ekundo/combolite/software/README.md

# Программы для «Вектора»

Программы под МикроДОС для платы ComboLite: терминал, IRC и Gopher через
Wi-Fi модем платы и настройки платы с самого «Вектора». Здесь только
исполняемые файлы, без исходников; свободно для некоммерческого
использования.

| файл | что |
|---|---|
| `TERM.COM` | терминал для BBS по telnet: ANSI, кодировки, прием файлов по XMODEM и Kermit |
| `IRC.COM` | клиент IRC |
| `GOPHER.COM` | клиент Gopher, в том числе для сайтов на GitHub Pages |
| `CL.COM` | настройки платы |
| `IRC.INI`, `GOPHER.INI` | примеры настроек: сервер и ник IRC, закладки Gopher |

Файлы нужно записать на дискету винчестера, на квазидиск или на дискету, как
любые другие программы. Модем — порты `28h`-`2Dh` (UART 16550), его устройство
описано в [MODEM.md](../doc/MODEM.md). TERM, IRC и GOPHER работают и в
эмуляторах, которые изображают этот модем.

## Настройки платы: CL.COM

Настройки платы, те же, что в веб-интерфейсе, меняет программа `CL.COM` под
МикроДОС, без компьютера и телефона. Ее нужно записать на дискету винчестера или на квазидиск, как любую
другую программу.

```
CL                       показать настройки и ждать команд
CL VGA=50 AUTO=OFF       поменять одну или несколько и показать итог
CL ?                     подсказка
```

Без параметров программа показывает настройки и ждет строк вида
`ИМЯ=ЗНАЧЕНИЕ`, несколько через пробел. Пустая строка — выход. Возможные
значения выписаны в скобках рядом с каждой настройкой:

| имя | что | значения |
|---|---|---|
| `BOOT` | загрузчик | `ROM`, `BOOT26` (`POWER` — старая настройка «только при включении») |
| `AUTO` | автозапуск загруженного | `ON`, `OFF` |
| `VGA` | выход VGA | `60`, `50` |
| `VI53` | звук таймера платы | `ON` — наш, `OFF` — «Вектора» |
| `FDC`, `KVAZ1`, `KVAZ2`, `IDE`, `AY`, `MIRROR` | устройства: дисковод, квазидиски 10h и 11h, винт, AY, зеркало экрана | `ON`, `OFF` |
| `READY` | готовность дисковода | `INDEX`, `34`, `ALWAYS` |
| `CABLE` | шлейф дисковода | `SHUGART`, `PC` |
| `PRECOMP`, `TG43` | предкомпенсация записи: шагов по 62,5 нс и «только с 44-й дорожки» | `0`-`8`; `ON`, `OFF` |

Изменение действует сразу и запоминается, как из веб-интерфейса. Все поля
уходят на плату вместе: если одно значение не подходит, не меняется ничего.
`IDE=OFF` прячет от «Вектора» винчестер, с которого программа, скорее всего,
и загружена: вернуть его можно из веб-интерфейса или той же программой с
дискеты или квазидиска.

`CL.COM` говорит с платой через порты `28h`-`2Dh` (UART 16550, за ним
модем; программа переводит канал в кадры настроек строкой `AT*CL`, а на
выходе возвращает модем), настройки хранит ESP.
Если программа пишет `No ComboLite`, плата не отвечает на порт `2Dh`. Если
пишет, что ESP не отвечает, в плате прошивка ПЛИС или ESP без этого канала:
обновите обе.

## Терминал: TERM.COM и Wi-Fi модем

Плата работает как Wi-Fi модем Hayes: ESP держит соединение и понимает
AT-команды, а «Вектор» видит модем как COM-порт с UART 16550 на портах
`28h`-`2Dh` (`28h` — данные, `2Dh` — состояние). Подойдут и старые программы
под такой порт, если принимают опросом, а не по прерыванию. Устройство
портов и команды модема описаны в
[MODEM.md](../doc/MODEM.md): тот же модем может изобразить и эмулятор. Терминал,
разбор ANSI, кодировки и прием файлов — программа `TERM.COM` на самом
«Векторе». Так доступны BBS, чаты и сетевые игры по telnet.

```
TERM          кодировку BBS терминал определяет сам
TERM /437     CP437 (англоязычные BBS, ANSI-арт)
TERM /866     CP866 (русские BBS)
TERM /1251    CP1251
TERM /KOI8    KOI8-R
TERM /UTF     UTF-8
TERM ?        справка
```

Кодировку TERM узнает по тому, что шлет BBS: правильные последовательности
UTF-8 — это UTF-8. Иначе байты 8-битные, и кодировку решают частые русские
буквы (о, е, а, и, н, т, с, р, в, л): в CP866, CP1251 и KOI8-R они стоят на
разных местах. Шесть таких букв — и кодировка выбрана. Уже нарисованное до
этого не перерисовывается. Пока русских букв нет, рисуется CP437. С каждым
новым соединением кодировка определяется заново. Если TERM ошибается,
запустите его с ключом. Знаков, которых нет в шрифте «Вектора» (CP866),
терминал заменяет похожими: буквы с надстрочными знаками — на латиницу без
них, кавычки, тире и стрелки — на `"`, `-`, `<` `>`, многоточие — на три
точки; совсем незнакомое — `?`.

Без соединения клавиши идут модему, и он понимает AT-команды:

| команда | что |
|---|---|
| `ATDT хост:порт` | соединиться (порт по умолчанию 23) |
| `+++` с паузой в секунду до и после | вернуться к командам, соединение остается |
| `ATO` | снова в соединение |
| `ATH` | разъединиться |
| `ATE0`, `ATE1` | эхо команд выключить, включить |
| `ATI` | имя модема |
| `ATBBS` | сколько BBS в списке |
| `ATBBS слово` | найти BBS по имени, адресу, программе или месту: до 15 строк с номерами |
| `ATDS n` | соединиться с BBS номер n из списка |
| `ATDL` | набрать прошлый адрес еще раз |
| `A/` | повторить прошлую команду |
| `AT?` | справка по командам |

Список BBS — месячный выпуск [Telnet BBS Guide](https://www.telnetbbsguide.com).
ESP скачивает его сама при первой команде `ATBBS` или `ATDS` (нужен интернет,
это занимает несколько секунд) и держит в памяти сутки, потом берет свежий.
В прошивку список не вшит: он меняется каждый месяц, а условия Telnet BBS Guide
не разрешают включать его в программы без спроса. Номера BBS действуют внутри
одного выпуска.

Стрелки вверх и вниз в командах модема вспоминают прежние строки. Историю,
20 строк, TERM хранит в файле `TERM.HIS` на текущем диске: читает при входе,
пишет при выходе. Пока модем в соединении, стрелки уходят на BBS. Что модем в
командах, TERM понимает по его ответам: `CONNECT` — соединение; `OK`, `ERROR`,
`NO CARRIER`, `NO ANSWER` — команды.

| клавиши | что |
|---|---|
| `УС`+`1` | справка по клавишам |
| `УС`+`2` | набрать: прежние адреса из истории или новый |
| `УС`+`3` | файлы: принять по XMODEM, принять или передать по Kermit |
| `УС`+`4` | положить трубку, даже если BBS не отвечает: `+++` и `ATH` с паузами |
| `УС`+`5`, правая кнопка мыши | меню |
| `УС`+`Q` | выход в ОС: сначала TERM кладет трубку (`+++` и `ATH`, около 3 с), чтобы следующая программа не попала в чужое соединение. На РУС это `УС`+`Я` |
| `АР2` | ESC на BBS |
| `РУС/ЛАТ` | русские буквы (в кодировке BBS: CP866, CP1251, KOI8-R или UTF-8) |
| стрелки, `F1`-`F5`, `↖`, `СТР` | в соединении — как на ПК (последовательности ANSI) |

**Меню и окна.** В меню «Связь» — набрать, положить трубку, выход; «Файл» —
прием файла; «Вид» — кодировка и число строк; «Справка». Стрелки выбирают,
`ВК` выполняет, `АР2` закрывает. С мышью (протокол KTSerg) меню и списки
работают щелчками, щелчок мимо окна закрывает его. Окна рисуются поверх
экрана BBS; что под ними, TERM на это время кладет на первый квазидиск и потом
возвращает. Поэтому TERM нужно 43 КБ свободного места на первом квазидиске:
два куска, 32 КБ под экран и 11 КБ под копию ОС, каждый целиком в одном банке
по 64 КБ. Файлы и каталог при этом не трогаются, ОС эти блоки по-прежнему
считает свободными. Если места нет, TERM говорит об этом и выходит.

TERM и IRC.COM проверены под МикроДОС T-72 (из ПЗУ и с дискеты), T-34 и RDS:
эти ОС держат свой код в квазидиске за окном A000h-DFFFh, и экран программы его
не задевает. RDS при запуске заводит скрытые `RDS.SYS` и `COMMAND.SYS`; место
программы берут в обход них. ОС, у которой код лежит прямо в видеопамяти,
программа не тронет: скажет об этом и выйдет.

Если прошлая программа вышла, не положив трубку (например, «Вектор» сбросили),
TERM и IRC.COM при входе узнают это у платы и сами кладут трубку (около
2,5 с).

**Эхо.** Включать и выключать его не нужно: если telnet-сервер не показывает
набранное сам (так делают многие MUD, например `bylins.su:4000`), его
показывает модем. Когда сервер просит пароль и выключает эхо, модем тоже
молчит, и пароль не виден.

**Строка состояния.** Терминал — 80×24, как VT100, и модем сообщает BBS этот
размер. Нижняя строка экрана — строка состояния: на связи или в командах
модема, адрес (если набирали из TERM), время на связи, кодировка, подсказка.
ANSI-арт, нарисованный под 25 строк, смотрите с «Вид» → «25 строк»: строка
состояния уходит, терминал занимает весь экран. Обратно — тем же пунктом.

Если BBS ушла, оставив черный цвет на черном, TERM после `NO CARRIER`
возвращает обычные цвета. Само слово `NO CARRIER` тоже видно.

**IRC и другие серверы без telnet.** Если сервер начинает не с команд
telnet, модем передает байты как есть. Эха нет, на `PING` сервера нужно
отвечать самому. Для IRC есть отдельная программа, `IRC.COM`.

**Прием файла (XMODEM).** Запустите на BBS передачу файла по XMODEM, нажмите
`УС`+`3` и выберите «Принять: XMODEM». TERM спросит имя файла (можно с диском: `B:GAME.ZIP`; пустая строка —
назад в терминал), и дальше файл идет на диск, по килобайту на строке. Любая
клавиша прерывает прием, недокачанный файл удаляется. Блоки по 128 и 1024
байта, CRC-16 или контрольная сумма, повторы при сбоях. На время приема экран —
консоль ОС: TERM возвращает ей память, чтобы писать через нее на диск. Потом
терминал возвращается с пустым экраном. Последний блок XMODEM добит кодом
`1Ah`, как принято в CP/M, — так файл и записывается.

**Kermit.** `УС`+`3`, «Принять: Kermit» — запустите на другой стороне `SEND`;
имя файла придет от нее (путь отбрасывается, имя приводится к виду CP/M,
негодное заменяется на `KERMIT.DAT`). «Передать: Kermit» — TERM спросит имя
файла, на другой стороне запустите `RECEIVE`. Короткие пакеты до 94 байт,
сумма типа 1, управляющие знаки — через `#`, 8-битные идут как есть (модем
держит telnet BINARY); при приеме TERM соглашается на сжатие повторов `~`.
Как и с XMODEM, на время передачи экран — консоль ОС, любая клавиша отменяет
передачу. Проверено против C-Kermit 9.0 в обе стороны.

В 80 колонках у «Вектора» четыре цвета на экран, а BBS рисуют шестнадцатью.
TERM сводит их к четырем постоянным: черный — фон, все темные цвета — темный
бирюзовый, серый — серый, все яркие — белый.

Терминал на время работы забирает «Вектор» целиком: свой обработчик кадра,
опрос клавиатуры, палитра и прокрутка. При выходе он возвращает ОС память,
которую занимал (`9400h`-`9FFFh` и `E000h`-`FFFFh`), а экран консоли очищает.
Палитру и регистр квазидиска TERM узнает у платы при входе и возвращает при
выходе. Так он работает и под МикроДОС, и под RDS.

## IRC: IRC.COM

`IRC.COM` — IRC-клиент через тот же Wi-Fi модем. Подключение, регистрацию на
сервере, ответы на `PING` и кодировки он ведет сам.

```
IRC           подключиться по IRC.INI
IRC ?         справка
```

Настройка — файл `IRC.INI` на текущем диске:

```
SERVER irc.lucky.net:7777
NICK vector
NAME Vector-06C
CHARSET UTF
/join #vector
```

`CHARSET` — в какой кодировке отправлять: `UTF`, `1251`, `KOI8` или `866`.
На RusNet кодировку выбирает порт сервера: по
[irclist.ru](https://irclist.ru) у `irc.lucky.net` порт 7777 — UTF-8, а на
большинстве серверов сети 6667 — KOI8-R, 6669 — CP1251. `CHARSET` должен
совпадать с портом, иначе русский придет кракозябрами.
Строки с `/` — команды, которые IRC.COM выполнит, как только сервер примет
ник: войти в каналы, назваться NickServ. Если ник занят, IRC.COM добавляет к
нему `_` и пробует снова.

Экран: строки сверху — общая лента всех каналов и приватов, строка из чужого
канала помечена `[#канал]`. Сообщение, где упомянут ваш ник, выделено. Под
лентой — строка состояния: ник и цели (каналы и приваты) с номерами, текущая
в скобках, где появилось новое — со звездочкой; справа — сервер или что со
связью. Внизу — строка ввода.

Входящую строку IRC.COM читает как UTF-8, если она им правильно записана, а
иначе как 8-битную в кодировке из `CHARSET` (при `UTF` — CP1251). Поэтому
русский из UTF-8 и CP1251 в одной ленте читается без настройки.

| команда | что |
|---|---|
| текст без `/` | в текущую цель |
| `/join #канал`, `/j` | войти в канал |
| `/part [#канал] [текст]` | выйти |
| `/msg ник текст` | личное сообщение |
| `/query ник`, `/q` | открыть приват как цель |
| `/me текст` | действие |
| `/nick ник` | сменить ник |
| `/topic [текст]`, `/names` | тема, кто в канале |
| `/list слово` | каналы, где слово есть в имени или теме (без учета регистра, по-русски тоже); `/list #имя,#имя` — точные имена; `/list` — все |
| `/close` | закрыть текущую цель |
| `/server хост:порт` | на другой сервер |
| `/cs utf`, `1251`, `koi8`, `866` | кодировка отправки |
| `/raw строка` | серверу как есть |
| `/quit [текст]` | выйти с сервера и в ОС |
| `/help` | справка |

Прочие `/КОМАНДА ...` уходят серверу как есть: `/whois ник`, `/list`, `/away`.

| клавиши | что |
|---|---|
| `F1`-`F5`, `УС`+`N`, `УС`+`P` | сменить текущую цель |
| `ТАБ` | дополнить ник из тех, кто недавно писал |
| вверх, вниз | прежние строки ввода |
| влево, вправо, `↖`, `ЗБ`, `СТР` | правка строки |
| `АР2` | стереть строку |
| `УС`+`L` | очистить ленту |
| `УС`+`↑`, `УС`+`↓` | листать ленту назад и вперед по строке; `УС`+`←`, `УС`+`→` — по странице. Пока листаете, новые строки ждут в модеме; любая другая клавиша — назад к живой ленте |
| `УС`+`1` | справка по клавишам |
| `УС`+`2` | войти в канал |
| `УС`+`3` | список целей: выбрать текущую |
| `УС`+`4` | отключиться от сервера, IRC.COM остается |
| `УС`+`5`, правая кнопка мыши | меню: Сервер, Каналы, Вид, Справка |
| `УС`+`Q` | выход в ОС: `QUIT` серверу и трубка |

Окна IRC.COM устроены как у TERM. Вместе с историей ленты (200 строк, 32 КБ)
IRC.COM нужно 75 КБ на первом квазидиске: три куска, 32, 32 и 11 КБ, каждый в
одном банке.

Ник, цели и историю ввода IRC.COM пишет в `IRC.HIS` при выходе. Соединение
при выходе закрывается, при следующем запуске IRC.COM подключается заново.

## Gopher: GOPHER.COM

`GOPHER.COM` — клиент Gopher (RFC 1436) через тот же Wi-Fi модем. Gopher
вместо страниц показывает меню: каждый пункт ведет на текст, другое меню,
поиск или файл. Серверы живы и сейчас, например `gopher.floodgap.com`.

```
GOPHER                          домашняя страница
GOPHER gopher.floodgap.com      меню сервера
GOPHER хост:порт/0/путь         текст (тип 0) по строке выбора «путь»
GOPHER ?                        справка
```

Адрес — `хост[:порт][/тип путь]`, можно с `gopher://` в начале. Порт по
умолчанию 70, тип — `1` (меню). ОС переводит хвост команды в заглавные
буквы, поэтому GOPHER берет адрес из командной строки строчными. Если путь
на сервере с заглавными, откройте его через окно адреса или закладку.

Закладки — файл `GOPHER.INI` на текущем диске (если его там нет — на `A:`,
как у IRC.COM): в строке адрес и через пробел название. Первая закладка —
домашняя страница; без файла домашняя — `gopher.floodgap.com`.

```
gopher.floodgap.com Floodgap
gopher.floodgap.com/7/v2/vs Veronica-2: поиск
CHARSET KOI8
```

`CHARSET` — как читать 8-битный текст, который не в UTF-8: `1251` (так и без
строки), `KOI8` или `866`. Текст в правильном UTF-8 GOPHER узнает сам, по
каждой строке.

Экран: 24 строки документа и строка состояния. В строке состояния слева
адрес, справа набор, загрузка в КБ или положение («25-48/100» — какие
строки видны из скольких) либо сообщение. Перед пунктом меню стоят номер и
метка: `DIR` — меню, `TXT` — текст, `ASK` — поиск, `BIN`, `IMG`, `SND`,
`DOC` — файл, `WWW` — ссылка не на Gopher, `TEL` — telnet. Строки без
номера — пояснения, их не открыть. Выбранный пункт выделен. Длинные строки
текста переносятся по словам.

| клавиши | что |
|---|---|
| вверх, вниз | в меню — соседний пункт, в тексте — строка |
| цифры | пункт меню по номеру: выбран сразу, номер — в строке состояния; если пункта с таким номером нет, номер начинается с последней цифры |
| влево, вправо | страница |
| `↖`, `СТР` | начало и конец |
| `ВК` | открыть пункт |
| `ЗБ` | назад |
| `АР2` | прервать загрузку, а если ничего не грузится — назад |
| `УС`+`1` | справка по клавишам |
| `УС`+`2` | адрес: открыть свой |
| `УС`+`3` | сохранить в файл выбранный пункт (в тексте — сам текст) |
| `УС`+`4` | прервать загрузку |
| `УС`+`5`, правая кнопка мыши | меню: Адрес (закладки, домой, назад, обновить), Вид (кодировка), Справка |
| `УС`+`Q` | выход в ОС |

**Мышь.** Указатель появляется, как только мышь сдвинули. Левая кнопка по
пункту меню открывает его, по `<` в начале строки состояния (он есть, когда
есть куда возвращаться) — назад. Средняя кнопка — тоже назад, колесо листает
по 3 строки, правая кнопка — меню. В окнах мышь работает, как в TERM.

Поиск (`ASK`) спрашивает запрос в окне и отправляет его в UTF-8. Пункт с
файлом GOPHER сохраняет на диск: экран на это время уходит ОС, имя файла
спрашивается строкой (можно с диском: `B:GAME.ZIP`). В квадратных скобках —
имя по умолчанию, последнее звено пути: пустая строка сохраняет под ним, `-` —
назад. Дальше идет счет в КБ. Любая клавиша отменяет. Последнюю запись файла GOPHER, как
принято в CP/M, добивает байтами 1Ah. `WWW` и `TEL` GOPHER не открывает, а
показывает адрес: telnet открывается в TERM.

Gopher-«дыры», выложенные на GitHub Pages (хост `имя.github.io`), GOPHER
открывает так же, как обычные: модем сам скачивает их файлы по HTTPS
([MODEM.md](../doc/MODEM.md), «Gopher поверх HTTPS»). Адрес — `имя.github.io/1/репозиторий/`.

Документ (меню или текст) — до 32 КБ, больше — обрезается, в строке
состояния будет «обрезано». «Назад» помнит 6 адресов и место в каждом, а
документ скачивает заново. Между CONNECT и ответом сервера проходит около
секунды: столько модем ждет, чтобы понять, что это не telnet.

GOPHER.COM нужно 75 КБ на первом квазидиске, как IRC.COM: три куска, 32 КБ
под документ, 32 КБ под экран под окнами и 11 КБ под копию ОС. Строк экрана в
документе — до 800.

GOPHER.COM проверен в v06x под МикроДОС T-72 (с дискеты, запуск `A:GOPHER` с
C:), T-34 и RDS: меню, текст, запись файла, «назад», выход и повторный запуск.
