ekundo/combolite/doc/MODEM.md

# Wi-Fi модем для «Вектора-06Ц»: UART 16550 на порту 28h

Модем Hayes за портами в раскладке COM-порта ПК: подмножество UART 16550 с
базой 28h. Так он устроен на плате ComboLite (ESP32 за ПЛИС), и так же его
может изобразить эмулятор. Программы для «Вектора» видят только эти порты и
работают одинаково на плате и в эмуляторе. Под такой порт уже есть
VTTPX.COM С. В. Терентьева (терминал с XMODEM и YMODEM, 1998); наши TERM.COM,
IRC.COM, GOPHER.COM и CL.COM — тоже, они лежат в
[software](../software/README.md).

## Порты

| порт | регистр | чтение | запись |
|---|---|---|---|
| 28h | RBR / THR | байт от модема | байт модему |
| 29h | IER | — | пропускается |
| 2Ah | FCR | — | разряд 1 или 2 — очистить обе очереди |
| 2Bh | LCR | — | помнится только разряд 7 (DLAB) |
| 2Ch | MCR | — | пропускается |
| 2Dh | LSR | состояние | — |

При DLAB = 1 порты 28h и 29h — делитель скорости: запись туда пропускается и
модему не уходит, чтение 28h очередь не трогает. Скорости у канала нет, делитель
можно писать любой. Что в таблице не названо, не отвечает: шина дает FFh.
2Eh (MSR) и 2Fh (SCR) свободны, там джойстики у других плат.

Разряды LSR (порт 2Dh):

| разряд | что |
|---|---|
| 0 (DR) | есть байт от модема, 28h его отдаст |
| 5 (THRE) | есть место, байт в 28h модем примет |
| 6 (TEMT) | все отданное модему уже забрано |
| 1..4, 7 | 0 |

Пока модем молчит (на плате — ESP не отвечает), LSR = 00h: ни байта, ни
места. Программа считает, что модем есть, если `(in 2Dh) & 9Eh == 0` (пустая
шина дает FFh), и ждет разряда 5.

Перед каждым байтом программа проверяет разряд: 0 — перед чтением, 5 — перед
записью. Байт, записанный без места, пропадает. Чтение без байта дает
неопределенное значение. Глубина очередей не оговорена: на плате 14 байт в
каждую сторону, у эмулятора может быть больше. Скорость тоже не оговорена:
плата отдает до 14 байт за 0,5 мс, эмулятор может быстрее.

Прерываний у платы нет: принимать нужно опросом LSR. VTTPX.COM принимает по
прерыванию RST 6, поэтому на плате он пока не работает. В эмуляторе
прерывание по приему можно сделать.

Хорошая программа на входе ставит IER = 00h, LCR = 03h (8N1, DLAB = 0) и
MCR = 03h: тогда ей не важно, что оставила прошлая.

Очистка (FCR с разрядом 1 или 2) выбрасывает то, что лежит в очередях портов.
Соединение модема и данные, которые модем еще не положил в очередь, она не
трогает: программа, начавшая заново, продолжает с того же места.

## Модем

Поток байтов в обе стороны. Без соединения байты — командная строка, с
соединением — данные.

Команды начинаются с `AT` (буквы любого регистра) и кончаются CR:

| команда | что |
|---|---|
| `AT` | `OK` |
| `ATDT хост[:порт]` | соединиться по TCP, порт по умолчанию 23; `ATD` и `ATDP` так же |
| `ATDL` | набрать прошлый адрес |
| `ATH`, `ATH0` | разъединиться |
| `ATO` | вернуться в соединение после `+++` |
| `ATE0`, `ATE1` | эхо командной строки выключить, включить |
| `ATI` | имя модема |
| `ATZ` | сброс: эхо включено, соединения нет |
| `A/` | повторить прошлую команду, без CR |
| `AT?` | справка |

Ответы — слова между CR LF: `OK`, `ERROR`, `CONNECT`, `NO CARRIER`,
`NO ANSWER`. `ЗБ` (08h или 7Fh) стирает знак командной строки,
ESC-последовательности в ней пропускаются.

В соединении `+++` с тишиной не меньше секунды до и после возвращает в
командный режим, соединение остается. `NO CARRIER` приходит, когда сервер
закрыл соединение.

### Telnet и сырой TCP

Вид соединения модем узнает по первому байту сервера. IAC (FFh) — это
telnet: модем сам ведет согласование и вырезает команды telnet из потока.
Модем сам просит BINARY в обе стороны, поэтому файлы (XMODEM) идут через него
как есть. Модем отвечает на TERMINAL-TYPE словом `ANSI`, а на NAWS — размером
80×24, как у VT100: нижнюю строку экрана TERM.COM держит под строку состояния.
Пока telnet-сервер не обещал эхо (`WILL ECHO`), модем, как telnet-клиент,
сам возвращает машине набранное: ВК — как CR LF, ЗБ — как BS, пробел, BS;
последовательности ESC (стрелки, F1-F5) не возвращаются. Сервер включил свое
эхо (например, перед паролем, чтобы его скрыть) — модем молчит. У сырого TCP
эха нет: его делает программа (IRC.COM).

Если первый байт сервера — текст или сервер молчит секунду, соединение
считается сырым TCP (IRC и другие): байты идут как есть в обе стороны. Пока
вид соединения не ясен, байты от программы ждут в модеме.

### Gopher поверх HTTPS

GitHub Pages отдает файлы только по HTTPS, а клиент Gopher (GOPHER.COM) ходит
сырым TCP на порт 70. Набор хоста `*.github.io` на порт 70 (`ATDT
имя.github.io:70`) модем соединяет не с сетью, а с мостом. `CONNECT` приходит
сразу. Строку выбора модем принимает до CR или LF; запрос поиска после
табуляции отбрасывается, потому что на сайте лежат готовые файлы. Потом модем
скачивает `https://хост/путь` и отдает тело файла как ответ сервера Gopher.
Пустой путь и путь с `/` на конце означают `index.gph`. Пробелы и знаки не из
ASCII в пути уходят процентами. Конец файла — `NO CARRIER`, как при закрытии
TCP. Если файла нет (ошибка HTTP) или сайт недоступен, модем отдает меню из
одной строки `3Not found` или `3Cannot reach the site`, точку и
`NO CARRIER`. Больше 1 МБ модем не отдает.

Скачивание на плате идет через `esp_http_client`, сертификат сайта
проверяется набором корневых сертификатов ESP-IDF. Эмулятору мост
необязателен; v06x и Emu80 берут код модема платы с ним вместе и скачивают
через `curl`.

Эхо данных, разбор ANSI, кодировки, правка строки и протоколы передачи файлов
делает программа на «Векторе». Модем их не касается.

### Необязательное

Эмулятор может на эти команды отвечать `ERROR`:

| команда | что |
|---|---|
| `ATBBS [слово]` | список BBS из [Telnet BBS Guide](https://www.telnetbbsguide.com): без слова — сколько, со словом — поиск |
| `ATDS n` | набрать BBS номер n из списка |

## Только у платы ComboLite

Строка `AT*CL` и CR сразу после очистки переводят канал в кадры настроек
платы. Следующая очистка возвращает модем. Кадры описаны в `firmware/vchan.h`:
CL.COM меняет ими настройки и на выходе очищает канал, TERM.COM при входе
спрашивает запросом DIAG регистр квазидиска и палитру, чтобы вернуть их ОС на
выходе (эти порты только на запись). Последний байт ответа — 1, если модем на
линии: прошлая программа вышла, не положив трубку. Тогда TERM и IRC.COM при
входе кладут ее сами (`+++`, `ATH`).

Эмулятору, который изображает только модем, кадры не нужны. Строку `AT*CL`
и CR сразу после очистки ему лучше молча проглотить. Иначе при живом
соединении она уйдет на BBS, а без соединения модем ответит `ERROR` на экран
терминала. TERM.COM, не дождавшись ответа на DIAG, ставит на выходе регистр 0
и палитру консоли.

## Где код

- `fpga/hdl/vchan.v` — порты в ПЛИС платы.
- `firmware/modem.c`, `firmware/modem.h` — модем на C, общий для платы и
  эмулятора: неблокирующие сокеты, без потоков. `modem_put` и `modem_get` —
  трубы байтов, `modem_poll` — шаг сети. Сокеты — через `firmware/netcompat.h`
  (lwip на плате, POSIX и Winsock в эмуляторах).
- `firmware/vchan.c`, `firmware/vchan_esp.c` — канал платы: модем по
  умолчанию, кадры настроек по `AT*CL`.
- `firmware/fetch.h` — скачивание для моста Gopher: `fetch_esp.c` на плате,
  `fetch_curl.c` в эмуляторах.
- `firmware/bbslist.c`, `firmware/inflate.c` — список BBS (необязательный).
