ekundo/combolite/doc/ROADMAP.md

# Планы

Что дорабатывается в прошивке. Порядок — примерно по важности, сроков нет.

## Проверить на «Векторе»

То, что в прошивке уже есть, но еще не прогонялось на живом «Векторе»
(список — в [TESTED.md](TESTED.md)): чтение и запись на шлейфе дисковода от
ПК, накопители кроме CompactFlash.

## ПЛИС

- **Место в кристалле.** Занято 99 % LUT и все блоки памяти: под новые узлы
  места придется освобождать.
- **VGA 15 кГц.** Развертка как у самого «Вектора» (312 строк, 50 Гц) для
  ЭЛТ-телевизоров через SCART и мониторов, которые берут 15 кГц.

## ESP

- **Повтор прошивки ПЛИС.** Если заливка сорвалась, повтор сразу после нее
  сейчас отказывает с «out of memory», пока не пройдет пять минут или не
  перезапустится ESP. Повтор должен идти сразу.
- **Живой экран в браузере.** Сейчас снимок идет строка за строкой по запросу;
  нужна потоковая передача с бордюром и мультиколором.
- **Сообщения об ошибках.** Подсказки в журнале и веб-интерфейсе — с номерами
  разъемов этой платы и понятным действием.
