ekundo/combolite/hardware/production/combolite2-bom.csv

Reference | Value | Footprint | QUANTITY
A1 | ESP32-S3-WROOM-1U | combolite:ESP32-S3-WROOM-1U-D03 | 1
BT1 | CR2032 | Battery:BatteryHolder_Keystone_3034_1x20mm | 1
C1,C12,C13,C18,C20-C27,C48,C53,C58,C63,C68,C70,C73 | 10uF | Capacitor_SMD:C_1206_3216Metric | 19
C2,C8,C16,C83 | 22uF | Capacitor_SMD:C_1206_3216Metric | 4
C3,C5,C7,C15,C17,C28-C47,C49-C52,C54-C57,C59-C62,C64-C67,C69,C71,C72,C74-C82 | 100nF | Capacitor_SMD:C_0805_2012Metric | 53
C4,C19 | 1uF | Capacitor_SMD:C_0805_2012Metric | 2
C10,C11 | 1nF | Capacitor_SMD:C_0805_2012Metric | 2
C14 | 100uF | Capacitor_SMD:C_1210_3225Metric | 1
DD1 | LCMXO2-7000HE-4TG144C | Package_QFP:TQFP-144_20x20mm_P0.5mm | 1
DD2-DD5,DD8 | SN74LVC16T245 | Package_SO:TSSOP-48_6.1x12.5mm_P0.5mm | 5
DD6,DD6B? | AS6C4008-55ZIN | Package_SO:TSOP-II-32_21.0x10.2mm_P1.27mm | 2
DD7,DD7B? | 74AHCT574 | Package_SO:SOIC-20W_7.5x12.8mm_P1.27mm | 2
DD9,DD10 | 74HC590PW | Package_SO:TSSOP-16_4.4x5mm_P0.65mm | 2
DD11 | SN74AHCT540PWR | Package_SO:TSSOP-20_4.4x6.5mm_P0.65mm | 1
DD12 | SN74AHCT04PWR | Package_SO:TSSOP-14_4.4x5mm_P0.65mm | 1
DD13 | SN74AHCT1G08DBVR | Package_TO_SOT_SMD:SOT-23-5 | 1
DD14 | SN74LVC8T245PWR | Package_SO:TSSOP-24_4.4x7.8mm_P0.65mm | 1
F1 | 500mA | Resistor_SMD:R_1206_3216Metric | 1
F2 | MF-NSMF110-2 | Fuse:Fuse_1206_3216Metric | 1
F3 | MF-NSMF020-2 | Fuse:Fuse_1206_3216Metric | 1
FB1 | 600R@100MHz | Inductor_SMD:L_0805_2012Metric | 1
G1 | 50.000MHz 3.3V | Oscillator:Oscillator_SMD_EuroQuartz_XO53-4Pin_5.0x3.2mm_HandSoldering | 1
PWR1-PWR7 | PWR_FLAG |  | 7
R1,R98-R102,R112,R116-R120 | 1k | Resistor_SMD:R_0805_2012Metric | 12
R2,R3,R106,R107 | 4k7 | Resistor_SMD:R_0805_2012Metric | 4
R6,R111,R113 | 2k2 | Resistor_SMD:R_0805_2012Metric | 3
R7,R10,R11,R82,R83,R96,R97,R110 | 10k | Resistor_SMD:R_0805_2012Metric | 8
R8,R80,R81,R84,R85,R104,R105 | 100k | Resistor_SMD:R_0805_2012Metric | 7
R86,R89 | 487R | Resistor_SMD:R_0805_2012Metric | 2
R87,R90 | 976R | Resistor_SMD:R_0805_2012Metric | 2
R88,R91 | 1k96 | Resistor_SMD:R_0805_2012Metric | 2
R92 | 422R | Resistor_SMD:R_0805_2012Metric | 1
R93 | 845R | Resistor_SMD:R_0805_2012Metric | 1
R94,R95,R123 | 68R | Resistor_SMD:R_0805_2012Metric | 3
R114,R121 | 0R | combolite:R_0805_Select3 | 2
R122 | 120R | Resistor_SMD:R_0805_2012Metric | 1
RN1-RN3 | 100k | combolite:R_Array_4x0603_CommonBar | 3
TP10-TP16,TP20-TP24 | PAD | combolite:ProbeHole_1.6mm | 12
U1,U2 | LD1117S33TR | Package_TO_SOT_SMD:SOT-223-3_TabPin2 | 2
U3 | LD1117S12TR | Package_TO_SOT_SMD:SOT-223-3_TabPin2 | 1
VD2 | BAT54W-E3-08 | Diode_SMD:D_SOD-123 | 1
VD3 | 1N4148W-7-F | Diode_SMD:D_SOD-123 | 1
VD5 | MBR0540T1G | Diode_SMD:D_SOD-123 | 1
VT1,VT2 | BSS138 | Package_TO_SOT_SMD:SOT-23 | 2
XS1 | СНП34С-90В | combolite:SNP34S-90V-V | 1
XS2 | IDE | Connector_IDC:IDC-Header_2x20_P2.54mm_Vertical | 1
XS4 | 3.5 мм стерео | Connector_Audio:Jack_3.5mm_CUI_SJ1-3515N_Horizontal | 1
XS7 | DE-15 HD | Connector_Dsub:DSUB-15-HD_Socket_Horizontal_P2.29x1.90mm_EdgePinOffset3.03mm_Housed_MountingHolesOffset4.94mm | 1
XS8 | RP-SMA | Connector_Coaxial:SMA_Amphenol_132134_Vertical | 1
XS9 | USB-A | combolite:USB_A_Receptacle_GCT1046_WE629104 | 1
XS10 | IDC-34 | Connector_IDC:IDC-Header_2x17_P2.54mm_Vertical | 1
XS11 | питание IDE 5В | Connector_PinHeader_2.54mm:PinHeader_1x02_P2.54mm_Vertical | 1
