ekundo/combolite/hardware/production/bom-digikey.csv

Manufacturer Part Number | Manufacturer | Quantity 1 board | Quantity 2 boards | Reference Designator
CL21B104KBCNNNC | Samsung Electro-Mechanics | 53 | 106 | C3,C5,C7,C15,C17,C28-C47,C49-C52,C54-C57,C59-C62,C64-C67,C69,C71,C72,C74-C82
CL31A106KAHNNNF | Samsung Electro-Mechanics | 19 | 38 | C1,C12,C13,C18,C20-C27,C48,C53,C58,C63,C68,C70,C73
RC0805FR-071KL | YAGEO | 12 | 24 | R1,R98-R102,R112,R116-R120
RC0805FR-0710KL | YAGEO | 10 | 20 | R7,R10,R11,R14,R15,R82,R83,R96,R97,R110
RC0805FR-07100KL | YAGEO | 7 | 14 | R8,R80,R81,R84,R85,R104,R105
SN74LVC16T245DGGR | Texas Instruments | 5 | 10 | DD2-DD5,DD8
CL31A226MOCLNNC | Samsung Electro-Mechanics | 4 | 8 | C2,C8,C16,C83
RC0805FR-074K7L | YAGEO | 4 | 8 | R2,R3,R106,R107
YC164-JR-07100KL | YAGEO | 3 | 6 | RN1-RN3
CC0805KKX7R9BB105 | YAGEO | 3 | 6 | C4,C6,C19
RC0805FR-072K2L | YAGEO | 3 | 6 | R6,R111,R113
RC0805FR-0768RL | YAGEO | 3 | 6 | R94,R95,R123
RC0805JR-070RL | YAGEO | 3 | 6 | R108,R114,R121
RC0805FR-071K96L | YAGEO | 2 | 4 | R88,R91
CC0805JRNPO9BN102 | YAGEO | 2 | 4 | C10,C11
RC0805FR-07487RL | YAGEO | 2 | 4 | R86,R89
SN74AHCT574DWR | Texas Instruments | 2 | 4 | DD7,DD7B
74HC590PW,118 | Nexperia | 2 | 4 | DD9,DD10
RC0805FR-07976RL | YAGEO | 2 | 4 | R87,R90
AS6C4008-55ZIN | Alliance Memory | 2 | 4 | DD6,DD6B
BSS138 | onsemi | 2 | 4 | VT1,VT2
LD1117S33TR | STMicroelectronics | 2 | 4 | U1,U2
BHR-40-VUA | Adam Tech | 2 | 4 | IDE90:XS3,XS2
CC1210MKX5R7BB107 | YAGEO | 1 | 2 | C14
RC0805FR-07120RL | YAGEO | 1 | 2 | R122
1N4148W-7-F | Diodes Incorporated | 1 | 2 | VD3
SJ1-3515N | Same Sky | 1 | 2 | XS4
RC0805FR-07422RL | YAGEO | 1 | 2 | R92
ECS-5032MV-500-BN-TR | ECS Inc. | 1 | 2 | G1
1206L050YR | Littelfuse | 1 | 2 | F1
MPZ2012S601AT000 | TDK | 1 | 2 | FB1
RC0805FR-07845RL | YAGEO | 1 | 2 | R93
BAT54W-E3-08 | Vishay | 1 | 2 | VD2
3034TR | Keystone Electronics | 1 | 2 | BT1
HD15-SN-25 | Adam Tech | 1 | 2 | XS7
ESP32-S3-WROOM-1U-N4 | Espressif Systems | 1 | 2 | A1
BHR-34-VUA | Adam Tech | 1 | 2 | XS10
LCMXO2-7000HE-4TG144C | Lattice Semiconductor | 1 | 2 | DD1
LD1117S12TR | STMicroelectronics | 1 | 2 | U3
MBR0540T1G | onsemi | 1 | 2 | VD5
MF-NSMF020-2 | Bourns | 1 | 2 | F3
MF-NSMF110-2 | Bourns | 1 | 2 | F2
132134RP | Amphenol RF | 1 | 2 | XS8
SN74AHCT04PWR | Texas Instruments | 1 | 2 | DD12
SN74AHCT1G08DBVR | Texas Instruments | 1 | 2 | DD13
SN74AHCT540PWR | Texas Instruments | 1 | 2 | DD11
SN74LVC8T245PWR | Texas Instruments | 1 | 2 | DD14
629104151021 | Wurth Elektronik | 1 | 2 | XS9
61300211121 | Wurth Elektronik | 1 | 2 | XS11
3030-40-0103-00 | CnC Tech | 1 | 2 | IDE90:XT1
ANT-2.4-CW-RAH-RPS | TE Connectivity Linx | 1 | 2
2015699-1 | TE Connectivity | 1 | 2
