ekundo/combolite/hardware/kicad/combolite2.kicad_pcb

## KiCad design hardware/kicad/combolite2.kicad_pcb (2026-10-23)

Schematic: combolite2.kicad_sch, V06C ComboLite rev4 — квазидиски, IDE, ВГ93, AY, VGA, ESP32

Parts:
A1: ESP32-S3-WROOM-1U; ESP32-S3-WROOM-1U-D03
BT1: CR2032; BatteryHolder_Keystone_3034_1x20mm
C1, C12, C13, C18, C20, C21, C22, C23, C24, C25, C26, C27, C48, C53, C58, C63, C68, C70, C73: 10uF; C_1206_3216Metric
C2, C8, C16, C83: 22uF; C_1206_3216Metric
C3, C5, C7, C15, C17, C28, C29, C30, C31, C32, C33, C34, C35, C36, C37, C38, C39, C40, C41, C42, C43, C44, C45, C46, C47, C49, C50, C51, C52, C54, C55, C56, C57, C59, C60, C61, C62, C64, C65, C66, C67, C69, C71, C72, C74, C75, C76, C77, C78, C79, C80, C81, C82: 100nF; C_0805_2012Metric
C4, C19: 1uF; C_0805_2012Metric
C6: 1uF; C_0805_2012Metric; not fitted
C10, C11: 1nF; C_0805_2012Metric
C14: 100uF; C_1210_3225Metric
DD1: LCMXO2-7000HE-4TG144C; TQFP-144_20x20mm_P0.5mm
DD2, DD3, DD4, DD5, DD8: SN74LVC16T245; TSSOP-48_6.1x12.5mm_P0.5mm
DD6, DD6B: AS6C4008-55ZIN; TSOP-II-32_21.0x10.2mm_P1.27mm
DD7, DD7B: 74AHCT574; SOIC-20W_7.5x12.8mm_P1.27mm
DD9, DD10: 74HC590PW; TSSOP-16_4.4x5mm_P0.65mm
DD11: SN74AHCT540PWR; TSSOP-20_4.4x6.5mm_P0.65mm
DD12: SN74AHCT04PWR; TSSOP-14_4.4x5mm_P0.65mm
DD13: SN74AHCT1G08DBVR; SOT-23-5
DD14: SN74LVC8T245PWR; TSSOP-24_4.4x7.8mm_P0.65mm
F1: 500mA; R_1206_3216Metric
F2: MF-NSMF110-2; Fuse_1206_3216Metric
F3: MF-NSMF020-2; Fuse_1206_3216Metric
FB1: 600R@100MHz; L_0805_2012Metric
G1: 50.000MHz 3.3V; Oscillator_SMD_EuroQuartz_XO53-4Pin_5.0x3.2mm_HandSoldering
PWR1, PWR2, PWR3, PWR4, PWR5, PWR6, PWR7: PWR_FLAG
R1, R98, R99, R100, R101, R102, R112, R116, R117, R118, R119, R120: 1k; R_0805_2012Metric
R2, R3, R106, R107: 4k7; R_0805_2012Metric
R6, R111, R113: 2k2; R_0805_2012Metric
R7, R10, R11, R82, R83, R96, R97, R110: 10k; R_0805_2012Metric
R8, R80, R81, R84, R85, R104, R105: 100k; R_0805_2012Metric
R14, R15: 10k; R_0805_2012Metric; not fitted
R86, R89: 487R; R_0805_2012Metric
R87, R90: 976R; R_0805_2012Metric
R88, R91: 1k96; R_0805_2012Metric
R92: 422R; R_0805_2012Metric
R93: 845R; R_0805_2012Metric
R94, R95, R123: 68R; R_0805_2012Metric
R108: 0R; R_0805_2012Metric; not fitted
R114, R121: 0R; R_0805_Select3
R122: 120R; R_0805_2012Metric
RN1, RN2, RN3: 100k; R_Array_4x0603_CommonBar
TP10, TP11, TP12, TP13, TP14, TP15, TP16, TP20, TP21, TP22, TP23, TP24: PAD; ProbeHole_1.6mm
U1, U2: LD1117S33TR; SOT-223-3_TabPin2
U3: LD1117S12TR; SOT-223-3_TabPin2
VD2: BAT54W-E3-08; D_SOD-123
VD3: 1N4148W-7-F; D_SOD-123
VD5: MBR0540T1G; D_SOD-123
VT1, VT2: BSS138; SOT-23
XS1: СНП34С-90В; SNP34S-90V-V
XS2: IDE; IDC-Header_2x20_P2.54mm_Vertical
XS4: 3.5 мм стерео; Jack_3.5mm_CUI_SJ1-3515N_Horizontal
XS7: DE-15 HD; DSUB-15-HD_Socket_Horizontal_P2.29x1.90mm_EdgePinOffset3.03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
XS8: RP-SMA; SMA_Amphenol_132134_Vertical
XS9: USB-A; USB_A_Receptacle_GCT1046_WE629104
XS10: IDC-34; IDC-Header_2x17_P2.54mm_Vertical
XS11: питание IDE 5В; PinHeader_1x02_P2.54mm_Vertical

Connections:
ADDR_CPC: DD1.100 (PR5A), DD12.1
ADDR_MRC: DD1.103 (PR4C), DD12.5
ADDR_SRC: DD1.99 (PR5B), DD7.1 (OE), DD7B.1 (OE), DD12.9, R110.1
APH0: DD6.4 (A12), DD6B.4 (A12), DD7.18 (Q1), DD9.15 (Q0)
APH1: DD6.23 (A10), DD6B.23 (A10), DD7.19 (Q0), DD9.1 (Q1)
APH2: DD6.5 (A7), DD6B.5 (A7), DD7.17 (Q2), DD9.2 (Q2)
APH3: DD6.6 (A6), DD6B.6 (A6), DD7.16 (Q3), DD9.3 (Q3)
APH4: DD6.3 (A14), DD6B.3 (A14), DD7.15 (Q4), DD9.4 (Q4)
APH5: DD6.7 (A5), DD6B.7 (A5), DD7.14 (Q5), DD11.18 (Y0)
APH6: DD6.8 (A4), DD6B.8 (A4), DD7.13 (Q6), DD11.17 (Y1)
APH7: DD6.9 (A3), DD6B.9 (A3), DD7.12 (Q7), DD9.5 (Q5)
APL0: DD6.28 (A13), DD6B.28 (A13), DD7B.19 (Q0), DD11.16 (Y2)
APL1: DD6.25 (A11), DD6B.25 (A11), DD7B.18 (Q1), DD11.15 (Y3)
APL2: DD6.26 (A9), DD6B.26 (A9), DD7B.17 (Q2), DD11.14 (Y4)
APL3: DD6.27 (A8), DD6B.27 (A8), DD7B.16 (Q3), DD11.13 (Y5)
APL4: DD6.12 (A0), DD6B.12 (A0), DD7B.14 (Q5), DD11.12 (Y6)
APL5: DD6.31 (A15), DD6B.31 (A15), DD7B.15 (Q4), DD11.11 (Y7)
APL6: DD6.11 (A1), DD6B.11 (A1), DD7B.13 (Q6), R112.1
APL7: DD6.10 (A2), DD6B.10 (A2), DD7B.12 (Q7), DD9.6 (Q6)
AUDIO_L: DD1.85 (PR16B), R10.1
AUDIO_R: DD1.86 (PR16A), R11.1
AUD_L_F: C10.1, C12.1, R10.2
AUD_L_OUT: C12.2, R14.2, XS4.T
AUD_R_F: C11.1, C13.1, R11.2
AUD_R_OUT: C13.2, R15.2, XS4.R
BEEP_AC: C6.2, R14.1, R15.1
BEEP_IN_5V: C6.1, XS1.42 (СВОБОДН)
BLK_N: DD1.119 (PT27D/PROGRAMN), DD3.36 (2A1), R3.1, TP14.1
BLK_N_5V: DD3.13 (2B1), XS1.38 (~БЛК)
BUF_DIR: DD1.97 (PR7B), DD14.2 (DIR)
BUF_OE_N: DD1.68 (PB37A), DD14.22 (~OE), R113.1
CAS_N: DD1.142 (PT9B), DD2.35 (2A2)
CAS_N_5V: DD2.14 (2B2), XS1.22 (~CAS)
CHTVV_N: DD1.133 (PT15A), DD2.30 (2A5)
CHTVV_N_5V: DD2.19 (2B5), XS1.35 (~ЧТВВ)
CHTZU_N: DD1.139 (PT11A), DD2.33 (2A3)
CHTZU_N_5V: DD2.16 (2B3), DD13.2, XS1.34 (~ЧТЗУ)
CLK50: DD1.5 (PL6A/PCLKT5_0), G1.3 (OUT)
CNT_CPC: DD9.11 (CPC), DD10.11 (CPC), DD12.4
CNT_CPR: DD9.13 (CPR), DD10.13 (CPR), DD12.2, DD12.3
CNT_MRC_N: DD9.10 (~MRC), DD10.10 (~MRC), DD12.6
CNT_OE_N: DD9.14 (~OE), DD11.1 (G1), DD11.19 (G2), DD12.8
CNT_RCO_N: DD9.9 (~RCO), DD10.12 (~CE)
CNT_ROW0: DD9.7 (Q7), DD11.2 (A0), RN3.5 (R4)
CNT_ROW1: DD10.15 (Q0), DD11.3 (A1)
CNT_ROW2: DD10.1 (Q1), DD11.4 (A2)
CNT_ROW3: DD10.2 (Q2), DD11.5 (A3)
CNT_ROW4: DD10.3 (Q3), DD11.6 (A4)
CNT_ROW5: DD10.4 (Q4), DD11.7 (A5)
CNT_ROW6: DD10.5 (Q5), DD11.8 (A6)
CNT_ROW7: DD10.6 (Q6), DD11.9 (A7)
ESP_CS: A1.18 (IO10), DD1.42 (PB9A)
ESP_EN: A1.3 (EN), C19.1, R96.1, TP22.1
ESP_IO0: A1.27 (IO0), R97.1, TP23.1
ESP_MISO: A1.21 (IO13), DD1.41 (PB6B)
ESP_MOSI: A1.19 (IO11), DD1.39 (PB4B)
ESP_RXD0: A1.36 (RXD0), TP21.1
ESP_SCK: DD1.38 (PB4A), R123.2
ESP_SCK_A1: A1.20 (IO12), R123.1
ESP_TXD0: A1.37 (TXD0), TP20.1
FDD_DIR_N: DD1.35 (PL25B), DD5.32 (2A4)
FDD_DIR_N_5V: DD5.17 (2B4), XS10.18
FDD_DS0_N: DD1.32 (PL24A), DD5.36 (2A1)
FDD_DS0_N_5V: DD5.13 (2B1), XS10.10
FDD_DS1_N: DD1.33 (PL24B), DD5.35 (2A2)
FDD_DS1_N_5V: DD5.14 (2B2), XS10.12
FDD_INDEX_N: DD1.50 (PB16B/PCLKC2_0), R116.2
FDD_INDEX_N_C: R98.1, R116.1, XS10.8
FDD_MOTON_N: DD1.34 (PL25A), DD5.33 (2A3)
FDD_MOTON_N_5V: DD5.16 (2B3), XS10.16
FDD_RDATA_N: DD1.55 (PB23A/PCLKT2_1), R119.2
FDD_RDATA_N_C: R101.1, R119.1, XS10.30
FDD_RDY_N: DD1.56 (PB23B/PCLKC2_1), R120.2
FDD_RDY_N_C: R102.1, R120.1, XS10.34
FDD_SIDE1_N: DD1.49 (PB16A/PCLKT2_0), DD5.26 (2A8)
FDD_SIDE1_N_5V: DD5.23 (2B8), XS10.32
FDD_STEP_N: DD1.43 (PB9B), DD5.30 (2A5)
FDD_STEP_N_5V: DD5.19 (2B5), XS10.20
FDD_TRK00_N: DD1.52 (PB18A), R117.2
FDD_TRK00_N_C: R99.1, R117.1, XS10.26
FDD_WDATA_N: DD1.47 (PB13A), DD5.29 (2A6)
FDD_WDATA_N_5V: DD5.20 (2B6), XS10.22
FDD_WGATE_N: DD1.48 (PB13B), DD5.27 (2A7)
FDD_WGATE_N_5V: DD5.22 (2B7), XS10.24
FDD_WPT_N: DD1.54 (PB18B), R118.2
FDD_WPT_N_C: R100.1, R118.1, XS10.28
GND: A1.1 (GND), A1.40 (GND), A1.41 (GND), BT1.2 (-), C1.2, C2.2, C3.2, C4.2, C5.2, C7.2, C8.2, C10.2, C11.2, C14.2, C15.2, C16.2, C17.2, C18.2, C19.2, C20.2, C21.2, C22.2, C23.2, C24.2, C25.2, C26.2, C27.2, C28.2, C29.2, C30.2, C31.2, C32.2, C33.2, C34.2, C35.2, C36.2, C37.2, C38.2, C39.2, C40.2, C41.2, C42.2, C43.2, C44.2, C45.2, C46.2, C47.2, C48.2, C49.2, C50.2, C51.2, C52.2, C53.2, C54.2, C55.2, C56.2, C57.2, C58.2, C59.2, C60.2, C61.2, C62.2, C63.2, C64.2, C65.2, C66.2, C67.2, C68.2, C69.2, C70.2, C71.2, C72.2, C73.2, C74.2, C75.2, C76.2, C77.2, C78.2, C79.2, C80.2, C81.2, C82.2, C83.2, DD1.8 (GND), DD1.18 (GND), DD1.29 (GND), DD1.46 (GND), DD1.53 (GND), DD1.64 (GND), DD1.80 (GND), DD1.90 (GND), DD1.101 (GND), DD1.116 (GND), DD1.124 (GND), DD1.134 (GND), DD2.1 (1DIR), DD2.4 (GND), DD2.10 (GND), DD2.15 (GND), DD2.21 (GND), DD2.24 (2DIR), DD2.28 (GND), DD2.34 (GND), DD2.39 (GND), DD2.45 (GND), DD3.4 (GND), DD3.10 (GND), DD3.15 (GND), DD3.21 (GND), DD3.26 (2A8), DD3.28 (GND), DD3.30 (2A5), DD3.32 (2A4), DD3.33 (2A3), DD3.34 (GND), DD3.35 (2A2), DD3.39 (GND), DD3.45 (GND), DD4.4 (GND), DD4.10 (GND), DD4.15 (GND), DD4.21 (GND), DD4.28 (GND), DD4.34 (GND), DD4.39 (GND), DD4.45 (GND), DD5.4 (GND), DD5.10 (GND), DD5.15 (GND), DD5.21 (GND), DD5.28 (GND), DD5.34 (GND), DD5.37 (1A8), DD5.39 (GND), DD5.45 (GND), DD6.16 (VSS), DD6B.16 (VSS), DD7.10 (GND), DD7B.10 (GND), DD8.1 (1DIR), DD8.4 (GND), DD8.10 (GND), DD8.13 (2B1), DD8.15 (GND), DD8.16 (2B3), DD8.17 (2B4), DD8.19 (2B5), DD8.20 (2B6), DD8.21 (GND), DD8.22 (2B7), DD8.23 (2B8), DD8.24 (2DIR), DD8.28 (GND), DD8.34 (GND), DD8.39 (GND), DD8.45 (GND), DD9.8 (GND), DD9.12 (~CE), DD10.8 (GND), DD10.14 (~OE), DD11.10 (GND), DD12.7 (GND), DD12.11, DD12.13, DD13.3 (GND), DD14.11 (GND), DD14.12 (GND), DD14.13 (GND), G1.2 (GND), PWR3.1, R2.2, R80.2, R81.2, R104.2, R105.2, R110.2, R122.2, RN1.1 (common), RN2.1 (common), RN3.1 (common), TP15.1, TP24.1, U1.1 (GND), U2.1 (GND), U3.1 (GND), VT1.2 (S), VT2.2 (S), XS1.1 (GND), XS1.11 (GND), XS1.20 (GND), XS1.24 (GND), XS1.33 (GND), XS1.45 (GND), XS2.2, XS2.19, XS2.22, XS2.24, XS2.26, XS2.30, XS2.40, XS4.S, XS7.5, XS7.6, XS7.7, XS7.8, XS7.10, XS7.SH, XS8.2 (Ext), XS9.4 (GND), XS9.SH (Shield), XS10.1, XS10.3, XS10.5, XS10.7, XS10.9, XS10.11, XS10.13, XS10.15, XS10.17, XS10.19, XS10.21, XS10.23, XS10.25, XS10.27, XS10.29, XS10.31, XS10.33, XS11.2
IDE_5V: F2.2, R108.1, XS11.1
IDE_CS0_N: DD1.26 (PL19B), DD5.43 (1A4)
IDE_CS0_N_5V: DD5.6 (1B4), XS2.37
IDE_CS1_N_5V: R7.1, XS2.38
IDE_DA0: DD1.23 (PL17A), DD5.47 (1A1)
IDE_DA0_5V: DD5.2 (1B1), XS2.35
IDE_DA1: DD1.24 (PL17B), DD5.46 (1A2)
IDE_DA1_5V: DD5.3 (1B2), XS2.33
IDE_DA2: DD1.25 (PL19A), DD5.44 (1A3)
IDE_DA2_5V: DD5.5 (1B3), XS2.36
IDE_DD0: DD1.21 (PL15A), DD4.26 (2A8)
IDE_DD0_5V: DD4.23 (2B8), XS2.17
IDE_DD1: DD1.20 (PL12B/PCLKC4_0), DD4.27 (2A7)
IDE_DD1_5V: DD4.22 (2B7), XS2.15
IDE_DD2: DD1.17 (PL11B), DD4.30 (2A5)
IDE_DD2_5V: DD4.19 (2B5), XS2.13
IDE_DD3: DD1.14 (PL10B), DD4.33 (2A3)
IDE_DD3_5V: DD4.16 (2B3), XS2.11
IDE_DD4: DD1.12 (PL9B), DD4.36 (2A1)
IDE_DD4_5V: DD4.13 (2B1), XS2.9
IDE_DD5: DD1.10 (PL8B), DD4.38 (1A7)
IDE_DD5_5V: DD4.11 (1B7), XS2.7
IDE_DD6: DD1.6 (PL6B/PCLKC5_0), DD4.41 (1A5)
IDE_DD6_5V: DD4.8 (1B5), XS2.5
IDE_DD7: DD1.3 (PL4A/L_GPLLT_IN), DD4.44 (1A3)
IDE_DD7_5V: DD4.5 (1B3), XS2.3
IDE_DD8: DD1.1 (PL3A/L_GPLLT_FB), DD4.47 (1A1)
IDE_DD8_5V: DD4.2 (1B1), XS2.4
IDE_DD9: DD1.2 (PL3B/L_GPLLC_FB), DD4.46 (1A2)
IDE_DD9_5V: DD4.3 (1B2), XS2.6
IDE_DD10: DD1.4 (PL4B/L_GPLLC_IN), DD4.43 (1A4)
IDE_DD10_5V: DD4.6 (1B4), XS2.8
IDE_DD11: DD1.9 (PL8A), DD4.40 (1A6)
IDE_DD11_5V: DD4.9 (1B6), XS2.10
IDE_DD12: DD1.11 (PL9A), DD4.37 (1A8)
IDE_DD12_5V: DD4.12 (1B8), XS2.12
IDE_DD13: DD1.13 (PL10A), DD4.35 (2A2)
IDE_DD13_5V: DD4.14 (2B2), XS2.14
IDE_DD14: DD1.15 (PL11A), DD4.32 (2A4)
IDE_DD14_5V: DD4.17 (2B4), XS2.16
IDE_DD15: DD1.19 (PL12A/PCLKT4_0), DD4.29 (2A6)
IDE_DD15_5V: DD4.20 (2B6), XS2.18
IDE_DD_DIR: DD1.22 (PL15B), DD4.1 (1DIR), DD4.24 (2DIR)
IDE_DIOR_N: DD1.27 (PL22A/PCLKT3_0), DD5.41 (1A5)
IDE_DIOR_N_5V: DD5.8 (1B5), XS2.25
IDE_DIOW_N: DD1.28 (PL22B/PCLKC3_0), DD5.40 (1A6)
IDE_DIOW_N_5V: DD5.9 (1B6), XS2.23
IDE_PIN20: R108.2, XS2.20
IDE_RESET_N: DD1.31 (PL23D), DD5.38 (1A7)
IDE_RESET_N_5V: DD5.11 (1B7), XS2.1
JTAGENB: DD1.120 (PT27C/JTAGENB), R1.1
KEY_SBR: DD1.111 (PT35B), R80.1, VT1.1 (G)
KEY_VVOD: DD1.69 (PB37B), R81.1, VT2.1 (G)
LATCH_CLK: DD1.141 (PT10A), DD7.11 (Cp)
LATCH_CLK2: DD1.140 (PT10B), DD7B.11 (Cp)
P1V2: C8.1, R114.1 (A), R122.1, U3.2 (VO)
P3V3: C2.1, C3.1, C4.1, C7.1, C22.1, C23.1, C24.1, C25.1, C26.1, C27.1, C32.1, C33.1, C34.1, C35.1, C36.1, C37.1, C38.1, C39.1, C40.1, C41.1, C42.1, C43.1, C44.1, C45.1, C49.1, C50.1, C54.1, C55.1, C59.1, C60.1, C64.1, C65.1, C75.1, DD1.7 (VCCIO5), DD1.16 (VCCIO4), DD1.30 (VCCIO3), DD1.37 (VCCIO2), DD1.51 (VCCIO2), DD1.66 (VCCIO2), DD1.79 (VCCIO1), DD1.88 (VCCIO1), DD1.102 (VCCIO1), DD1.118 (VCCIO0), DD1.123 (VCCIO0), DD1.135 (VCCIO0), DD2.31 (VCCA), DD2.42 (VCCA), DD3.24 (2DIR), DD3.31 (VCCA), DD3.42 (VCCA), DD4.31 (VCCA), DD4.42 (VCCA), DD5.1 (1DIR), DD5.24 (2DIR), DD5.31 (VCCA), DD5.42 (VCCA), DD8.31 (VCCA), DD8.42 (VCCA), DD14.1 (V_{CCA}), FB1.1, R1.2, R3.2, R6.2, R8.2, R98.2, R99.2, R100.2, R101.2, R102.2, R106.2, R107.2, R111.2, R113.2, R114.3 (B), R121.1 (A), TP16.1, U1.2 (VO), U3.3 (VI)
P3V3_ESP: A1.2 (3V3), C16.1, C17.1, C83.1, R96.2, R97.2, U2.2 (VO)
P3V3_OSC: C5.1, FB1.2, G1.1 (EN), G1.4 (V+), PWR2.1
P5V: C1.1, C14.1, C15.1, C61.1, C62.1, C63.1, C70.1, C71.1, C73.1, C74.1, C77.1, C78.1, C79.1, C80.1, C81.1, C82.1, DD5.7 (VCCB), DD5.18 (VCCB), DD7.20 (VCC), DD7B.20 (VCC), DD9.16 (VCC), DD10.16 (VCC), DD11.20 (VCC), DD12.14 (VCC), DD13.5 (VCC), F1.1, F2.1, F3.1, PWR1.1, R7.2, R82.2, R83.2, R112.2, R121.3 (B), U1.3 (VI), U2.3 (VI), VD2.2 (A), XS1.2 (+5V), XS1.44 (+5V)
RAM_OE_N: DD6.24 (OE#), DD6B.24 (OE#), DD13.4, R104.1
RAS_N: DD1.143 (PT9A), DD2.36 (2A1)
RAS_N_5V: DD2.13 (2B1), XS1.21 (~RAS)
SBROS_N: DD1.127 (PT18B/PCLKC0_1), DD2.26 (2A8)
SBROS_N_5V: DD2.23 (2B8), XS1.41 (~СБРОС)
SBR_5V: R82.1, VT1.3 (D), XS1.36 (СБР.СИС.)
SHAP0: DD1.126 (PT22C/SCL/PCLKT0_0), DD8.47 (1A1)
SHAP0_5V: DD7.3 (D1), DD7B.2 (D0), DD8.2 (1B1), XS1.12 (~ШАП0)
SHAP1: DD1.125 (PT22D/SDA/PCLKC0_0), DD8.46 (1A2)
SHAP1_5V: DD7.2 (D0), DD7B.3 (D1), DD8.3 (1B2), XS1.13 (~ШАП1)
SHAP2: DD1.122 (PT25A), DD8.44 (1A3)
SHAP2_5V: DD7.4 (D2), DD7B.4 (D2), DD8.5 (1B3), XS1.14 (~ШАП2)
SHAP3: DD1.121 (PT25B), DD8.43 (1A4)
SHAP3_5V: DD7.5 (D3), DD7B.5 (D3), DD8.6 (1B4), XS1.15 (~ШАП3)
SHAP4: DD1.117 (PT28A), DD8.41 (1A5)
SHAP4_5V: DD7.6 (D4), DD7B.7 (D5), DD8.8 (1B5), XS1.16 (~ШАП4)
SHAP5: DD1.115 (PT28B), DD8.40 (1A6)
SHAP5_5V: DD7.7 (D5), DD7B.6 (D4), DD8.9 (1B6), XS1.17 (~ШАП5)
SHAP6: DD1.114 (PT33A), DD8.38 (1A7)
SHAP6_5V: DD7.8 (D6), DD7B.8 (D6), DD8.11 (1B7), XS1.18 (~ШАП6)
SHAP7: DD1.113 (PT33B), DD8.37 (1A8)
SHAP7_5V: DD7.9 (D7), DD7B.9 (D7), DD8.12 (1B8), XS1.19 (~ШАП7)
SHAVV_N0: DD1.87 (PR15B), DD2.47 (1A1)
SHAVV_N0_5V: DD2.2 (1B1), XS1.3 (~ШАВВ0)
SHAVV_N1: DD1.89 (PR15A), DD2.46 (1A2)
SHAVV_N1_5V: DD2.3 (1B2), XS1.4 (~ШАВВ1)
SHAVV_N2: DD1.91 (PR12B/PCLKC1_0), DD2.44 (1A3)
SHAVV_N2_5V: DD2.5 (1B3), XS1.5 (~ШАВВ2)
SHAVV_N3: DD1.92 (PR12A/PCLKT1_0), DD2.43 (1A4)
SHAVV_N3_5V: DD2.6 (1B4), XS1.6 (~ШАВВ3)
SHAVV_N4: DD1.93 (PR11B), DD2.41 (1A5)
SHAVV_N4_5V: DD2.8 (1B5), XS1.7 (~ШАВВ4)
SHAVV_N5: DD1.94 (PR11A), DD2.40 (1A6)
SHAVV_N5_5V: DD2.9 (1B6), XS1.8 (~ШАВВ5)
SHAVV_N6: DD1.95 (PR9B), DD2.38 (1A7)
SHAVV_N6_5V: DD2.11 (1B7), XS1.9 (~ШАВВ6)
SHAVV_N7: DD1.96 (PR9A), DD2.37 (1A8)
SHAVV_N7_5V: DD2.12 (1B8), XS1.10 (~ШАВВ7)
SHD0: DD1.62 (PB31B), DD3.37 (1A8)
SHD0_5V: DD14.21 (B1), XS1.25 (ШД0)
SHD0_RAM: DD3.12 (1B8), DD6.15 (DQ2), DD6B.15 (DQ2), DD14.3 (A1), RN1.2 (R1)
SHD1: DD1.63 (PB31D), DD3.38 (1A7)
SHD1_5V: DD14.20 (B2), XS1.26 (ШД1)
SHD1_RAM: DD3.11 (1B7), DD6.14 (DQ1), DD6B.14 (DQ1), DD14.4 (A2), RN1.3 (R2)
SHD2: DD1.65 (PB35A), DD3.40 (1A6)
SHD2_5V: DD14.19 (B3), XS1.27 (ШД2)
SHD2_RAM: DD3.9 (1B6), DD6.13 (DQ0), DD6B.13 (DQ0), DD14.5 (A3), RN1.4 (R3)
SHD3: DD1.61 (PB31A), DD3.41 (1A5)
SHD3_5V: DD14.18 (B4), XS1.28 (ШД3)
SHD3_RAM: DD3.8 (1B5), DD6.17 (DQ3), DD6B.17 (DQ3), DD14.6 (A4), RN1.5 (R4)
SHD4: DD1.60 (PB29B), DD3.43 (1A4)
SHD4_5V: DD14.17 (B5), XS1.29 (ШД4)
SHD4_RAM: DD3.6 (1B4), DD6.18 (DQ4), DD6B.18 (DQ4), DD14.7 (A5), RN2.2 (R1)
SHD5: DD1.59 (PB29A), DD3.44 (1A3)
SHD5_5V: DD14.16 (B6), XS1.30 (ШД5)
SHD5_RAM: DD3.5 (1B3), DD6.19 (DQ5), DD6B.19 (DQ5), DD14.8 (A6), RN2.3 (R2)
SHD6: DD1.58 (PB26B), DD3.46 (1A2)
SHD6_5V: DD14.15 (B7), XS1.31 (ШД6)
SHD6_RAM: DD3.3 (1B2), DD6.20 (DQ6), DD6B.20 (DQ6), DD14.9 (A7), RN2.4 (R3)
SHD7: DD1.57 (PB26A), DD3.47 (1A1)
SHD7_5V: DD14.14 (B8), XS1.32 (ШД7)
SHD7_RAM: DD3.2 (1B1), DD6.21 (DQ7), DD6B.21 (DQ7), DD14.10 (A8), RN2.5 (R4)
SHD_DIR: DD1.67 (PB35B), DD3.1 (1DIR)
SRAM_CE0_N: DD1.109 (PT36D/DONE), DD3.29 (2A6)
SRAM_CE0_N_5V: DD3.20 (2B6), DD6.22 (CE#), R84.1
SRAM_CE1_N: DD1.110 (PT36C/INITN), DD3.27 (2A7)
SRAM_CE1_N_5V: DD3.22 (2B7), DD6B.22 (CE#), R85.1
SRAM_OE_N: DD1.98 (PR7A), DD13.1, R111.1
SRAM_PAGE0: DD1.104 (PR3B/R_GPLLC_IN), DD6.2 (A16), DD6B.2 (A16), RN3.2 (R1)
SRAM_PAGE1: DD1.105 (PR3A/R_GPLLT_IN), DD6.30 (A17), DD6B.30 (A17), RN3.3 (R2)
SRAM_PAGE2: DD1.106 (PR2B/R_GPLLC_FB), DD6.1 (A18), DD6B.1 (A18), RN3.4 (R3)
SSPI_CSSPIN: A1.4 (IO4), DD1.40 (PB6A/CSSPIN), R107.1
SSPI_MCLK: A1.5 (IO5), DD1.44 (PB12A/MCLK/CCLK)
SSPI_SI: A1.6 (IO6), DD1.71 (PB38B/SI/SISPI)
SSPI_SN: A1.8 (IO15), DD1.70 (PB38A/SN), R106.1
SSPI_SO: A1.7 (IO7), DD1.45 (PB12B/SO/SPISO)
STACK: DD1.128 (PT18A/PCLKT0_1), DD2.27 (2A7)
STACK_5V: DD2.22 (2B7), XS1.40 (СТЕК)
STROB: DD1.112 (PT35A), DD8.35 (2A2)
STROB_5V: DD8.14 (2B2), XS1.43 (СТРОБ)
TCK: DD1.131 (PT17C/TCK), R2.1, TP10.1
TDI: DD1.136 (PT14D/TDI), TP12.1
TDO: DD1.137 (PT14C/TDO), R8.1, TP13.1
TMS: DD1.130 (PT17D/TMS), TP11.1
USB_DM: A1.13 (USB_D-), XS9.2 (D-)
USB_DP: A1.14 (USB_D+), XS9.3 (D+)
USB_VBUS: C18.1, F1.2, PWR5.1, XS9.1 (VBUS)
VBAT_CELL: BT1.1 (+), VD3.2 (A)
VBAT_RAM: C69.1, C72.1, DD6.32 (VCC), DD6B.32 (VCC), PWR4.1, R84.2, R85.2, VD2.1 (K), VD3.1 (K)
VCCB_BUS: C46.1, C47.1, C48.1, C51.1, C52.1, C53.1, C56.1, C57.1, C58.1, C66.1, C67.1, C68.1, C76.1, DD2.7 (VCCB), DD2.18 (VCCB), DD3.7 (VCCB), DD3.18 (VCCB), DD4.7 (VCCB), DD4.18 (VCCB), DD8.7 (VCCB), DD8.18 (VCCB), DD14.23 (V_{CCB}), DD14.24 (V_{CCB}), PWR7.1, R121.2 (C)
VCC_CORE: C20.1, C21.1, C28.1, C29.1, C30.1, C31.1, DD1.36 (VCC), DD1.72 (VCC), DD1.108 (VCC), DD1.144 (VCC), PWR6.1, R114.2 (C)
VGA_5V: VD5.1 (K), XS7.9
VGA_5V_F: F3.2, VD5.2 (A)
VGA_B: R92.2, R93.2, XS7.3
VGA_B0: DD1.82 (PR18A), R93.1
VGA_B1: DD1.81 (PR18B), R92.1
VGA_G: R89.2, R90.2, R91.2, XS7.2
VGA_G0: DD1.78 (PR21A), R91.1
VGA_G1: DD1.77 (PR21B), R90.1
VGA_G2: DD1.76 (PR23A), R89.1
VGA_HS: DD1.83 (PR17B), R94.1
VGA_HSYNC: R94.2, XS7.13
VGA_R: R86.2, R87.2, R88.2, XS7.1
VGA_R0: DD1.75 (PR23B), R88.1
VGA_R1: DD1.74 (PR24A), R87.1
VGA_R2: DD1.73 (PR24B), R86.1
VGA_VS: DD1.84 (PR17A), R95.1
VGA_VSYNC: R95.2, XS7.14
VVOD_5V: R83.1, VT2.3 (D), XS1.39 (ВВОД.СИС.)
XLAT_OE_N: DD1.107 (PR2A/R_GPLLT_FB), DD2.25 (2OE), DD2.48 (1OE), DD3.25 (2OE), DD3.48 (1OE), DD4.25 (2OE), DD4.48 (1OE), DD5.25 (2OE), DD5.48 (1OE), DD8.25 (2OE), DD8.48 (1OE), R6.1
ZPVV_N: DD1.132 (PT15B), DD2.29 (2A6)
ZPVV_N_5V: DD2.20 (2B6), XS1.37 (~ЗПВВ)
ZPZU_N: DD1.138 (PT11B), DD2.32 (2A4)
ZPZU_N_5V: DD2.17 (2B4), DD6.29 (WE#), DD6B.29 (WE#), R105.1, XS1.23 (~ЗПЗУ)

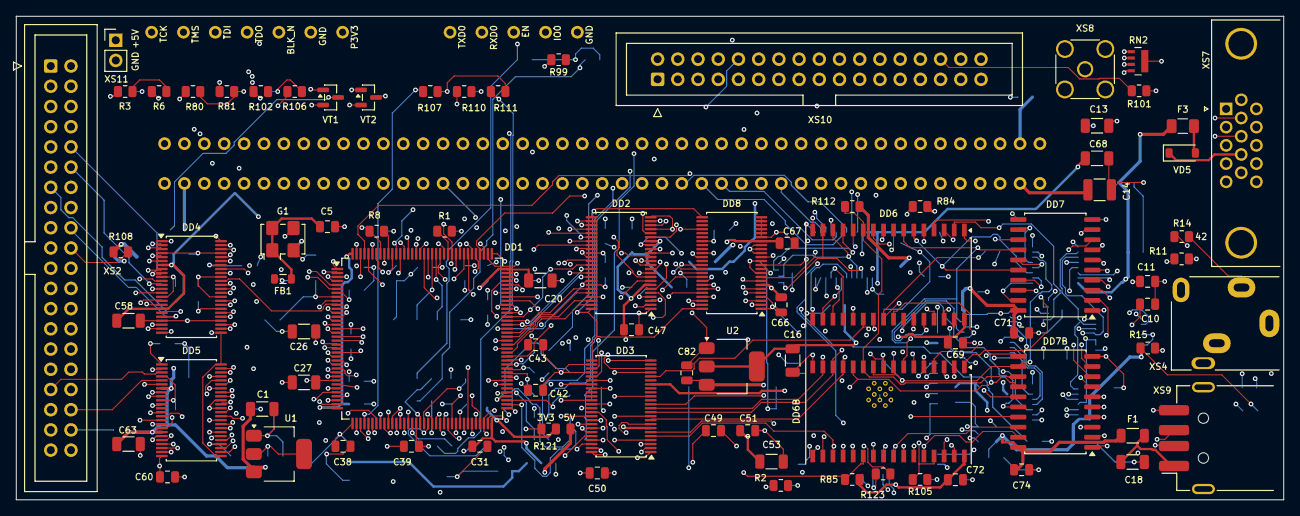
[picture p49: board combolite2.kicad_pcb from above]

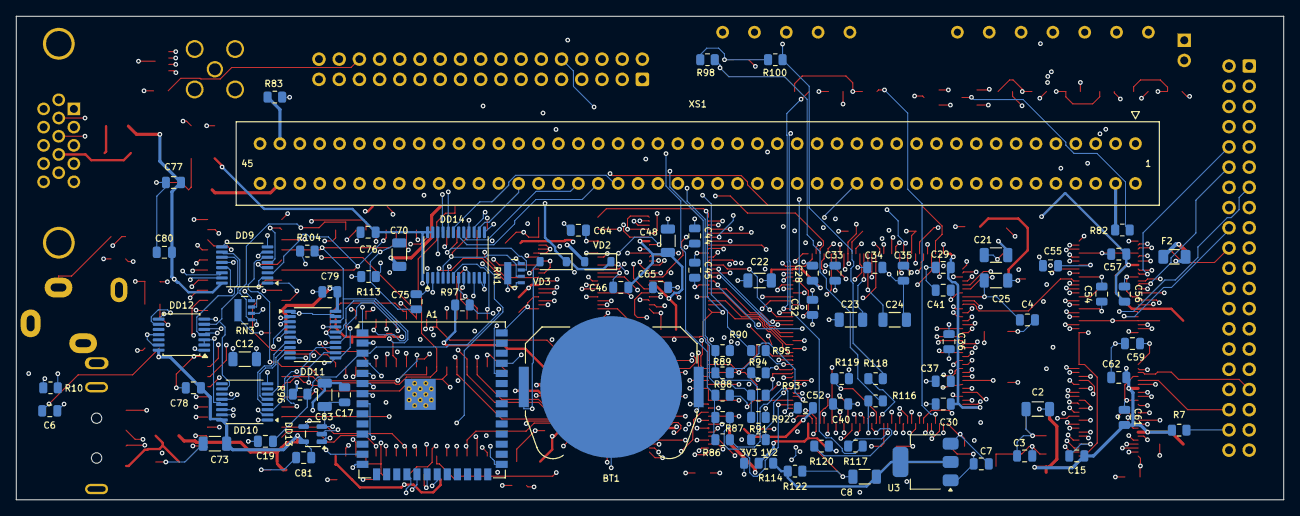
[picture p50: board combolite2.kicad_pcb from below]

Board: 6 copper layers, 159.2 x 60.8 mm, 187 parts (92 on the bottom side), 261 nets.
