ekundo/combolite/fpga/hdl/vid_phase.v

// Различитель видеоцикла и процессорного цикла на шине «Вектора».
//
// ЗАЧЕМ. Защёлка адреса строки (`DD7`, 574) тактуется каждым спадом `~RAS`,
// включая спады видеоадаптера. Внутрь строба нашего чтения такой спад попадает
// (замерено: ровно один), защёлка берёт видеоадрес, и ОЗУ отдаёт байт по чужому
// адресу. Здесь вырабатывается «сейчас придёт ВИДЕОспад», чтобы такт защёлки
// погасить заранее.
//
// ПОЧЕМУ НЕ ПО ПЕРИОДУ. Спады видеоадаптера идут через 1333 нс (Шашков, 1994,
// `caglrc.cc/scalar/media/w/bus.txt`), период 66..67 тактов без срывов, но
// предсказывать их по периоду нельзя. Механизм `READY` притягивает процессор к
// такту 3 КАЖДОГО цикла, поэтому при непрерывной работе процессорные спады
// периодичны ровно так же. Предсказатель по периоду захватывает один из двух
// потоков и не знает, который; захватив процессорный, гейт гасит процессорные
// строки, и чтения портятся во всех группах. Счётчики периода этого не видят:
// они СИММЕТРИЧНЫ относительно двух потоков -- за какой ни зацепись, второй
// выглядит как «один вставленный спад за период».
//
// ЧЕМ РАЗЛИЧАЮТСЯ НА САМОМ ДЕЛЕ -- ПРОМЕЖУТКОМ ПЕРЕД СПАДОМ. Замер логическим
// анализатором: промежутков между спадами ~RAS ровно четыре -- 480, 520, 800,
// 840 нс, короткий и длинный строго чередуются (751774 и 751774 за секунду, с
// платой и без), и потоки разделены по содержимому ~ШАП: видеоспад -- адрес +1
// каждый цикл, процессорный спад приходит через 480 нс после видеоспада. Значит
// видеоспад -- тот, перед которым был ДЛИННЫЙ промежуток (800-840 нс, 40-42
// такта), процессорный -- после короткого (24-26). Порог GAP_TH = 33 такта,
// запас по 7 в обе стороны, и ни строб, ни его полярность не нужны.
//
// ЧЕМ НЕ РАЗЛИЧАЮТСЯ -- СТРОБОМ. Считать видеоспадом тот, после которого до
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
