ekundo/combolite/(commit log)

2026-10-23 ComboLite: плата расширения для «Вектора-06Ц» — схема и плата KiCad, ПЛИС на Verilog, прошивка ESP32-S3, веб-интерфейс, документация
2026-10-23 Документы: мультиколор «работает», «Вектор» вместо «машины», без пункта про Black Ice в планах
2026-10-23 Документы: PDF руководства и инструкции по сборке; на чертежах сборки подпись «ComboLite»
2026-10-23 Подставной загрузчик: ~БЛК в окне только в цикле чтения памяти по слову состояния, различитель ВВОД видит шину; новый образ ПЛИС; в испытаниях загрузчик проверен
2026-10-23 VGA 60 Гц без шва и срывов: кадр VGA из одного кадра «Вектора», быстрый подвод счетчиков адреса, прокрутка от загрузки картинки; автозапуск — одна настройка на оба загрузчика; мышь видна ПЛИС сразу п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
2026-10-25 Wi-Fi модем за портами 28h-2Dh (UART 16550, команды Hayes): telnet и TCP, список BBS, мост Gopher к сайтам на GitHub Pages через HTTPS; VGA 60 Гц теперь 720×900 — половина 1440×900@60, точка «Вектора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
2026-10-25 Программы для «Вектора» под МикроДОС: TERM.COM (терминал для BBS, XMODEM и Kermit), IRC.COM, GOPHER.COM (в том числе сайты на GitHub Pages), CL.COM (настройки платы); примеры IRC.INI и GOPHER.INI; оп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
2026-10-25 Лицензии: программы в software/ — только исполняемые файлы, свободно для некоммерческого использования; software/ в составе репозитория
2026-10-26 README: предупреждение — rev4 собирать пока не стоит, найден баг VGA, который не исправить прошивкой; готовится rev5 с SD-картой вместо IDE и буфером кадра в ОЗУ
2026-10-26 README: в предупреждении — баг касается почти всех хороших игр, они рисуют синхронно с лучом
